KoNarRobotics/ModuCard-System/pcb/power-board/doc/mini_module_template-schematic.pdf

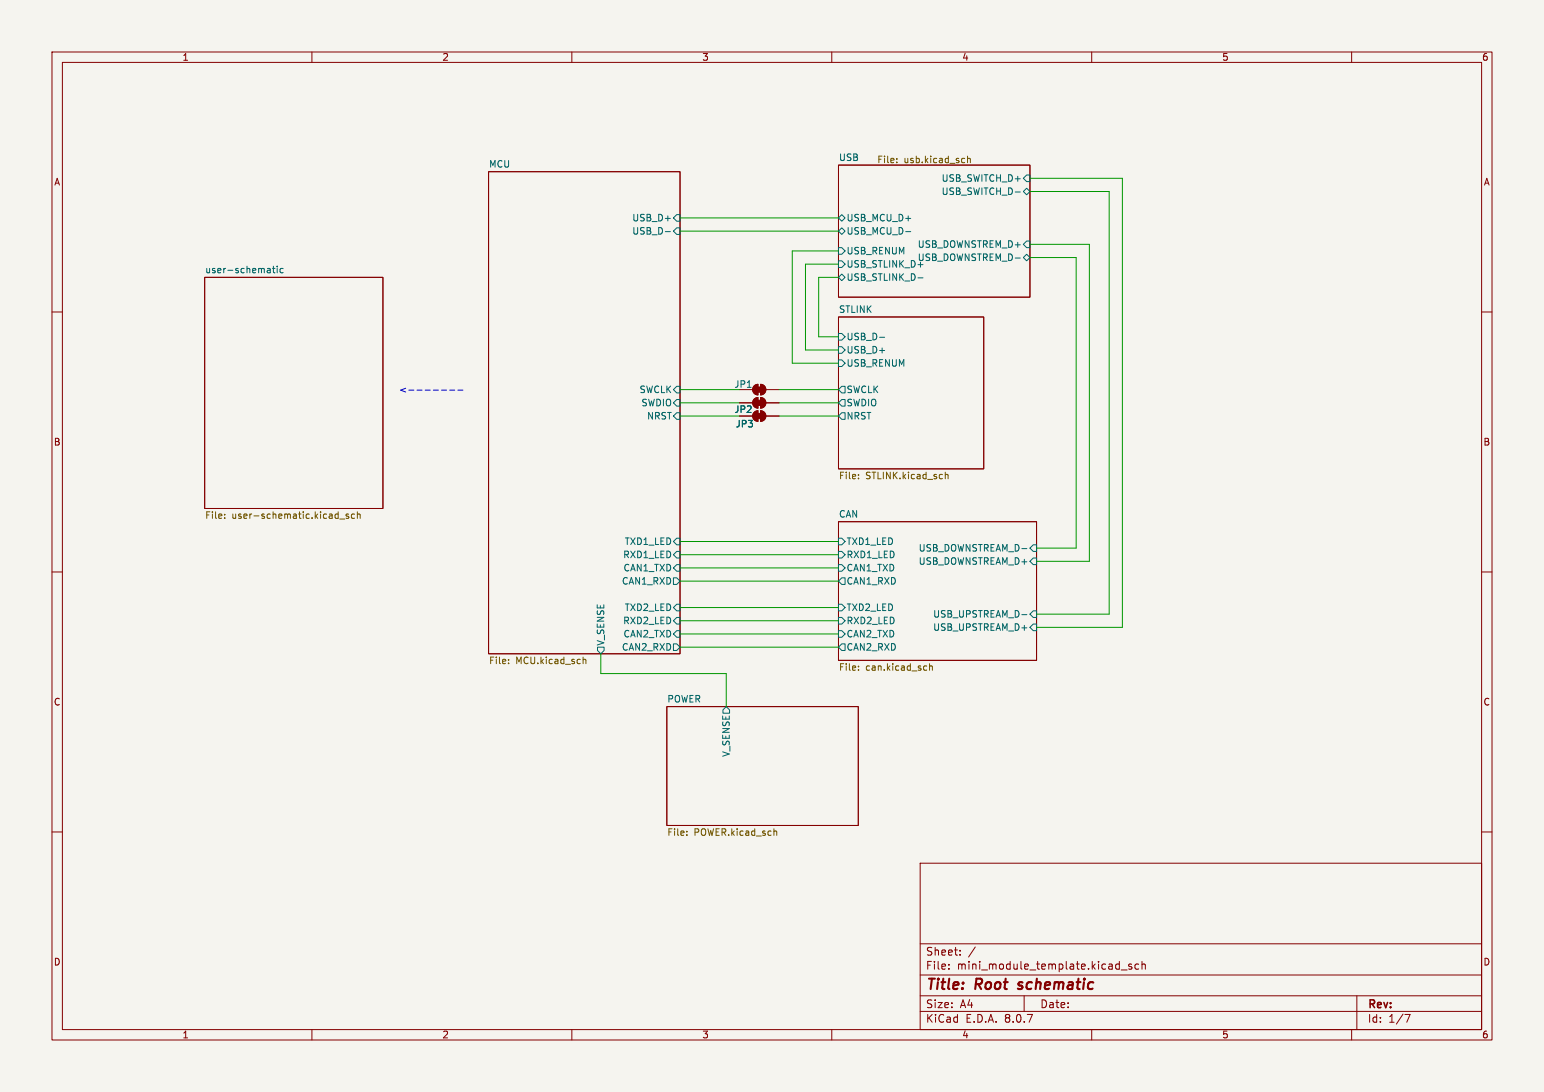
[picture p1: page 1]

File: mini_module_template.kicad_sch Sheet: /
Id: 1/7 Title: Root schematic

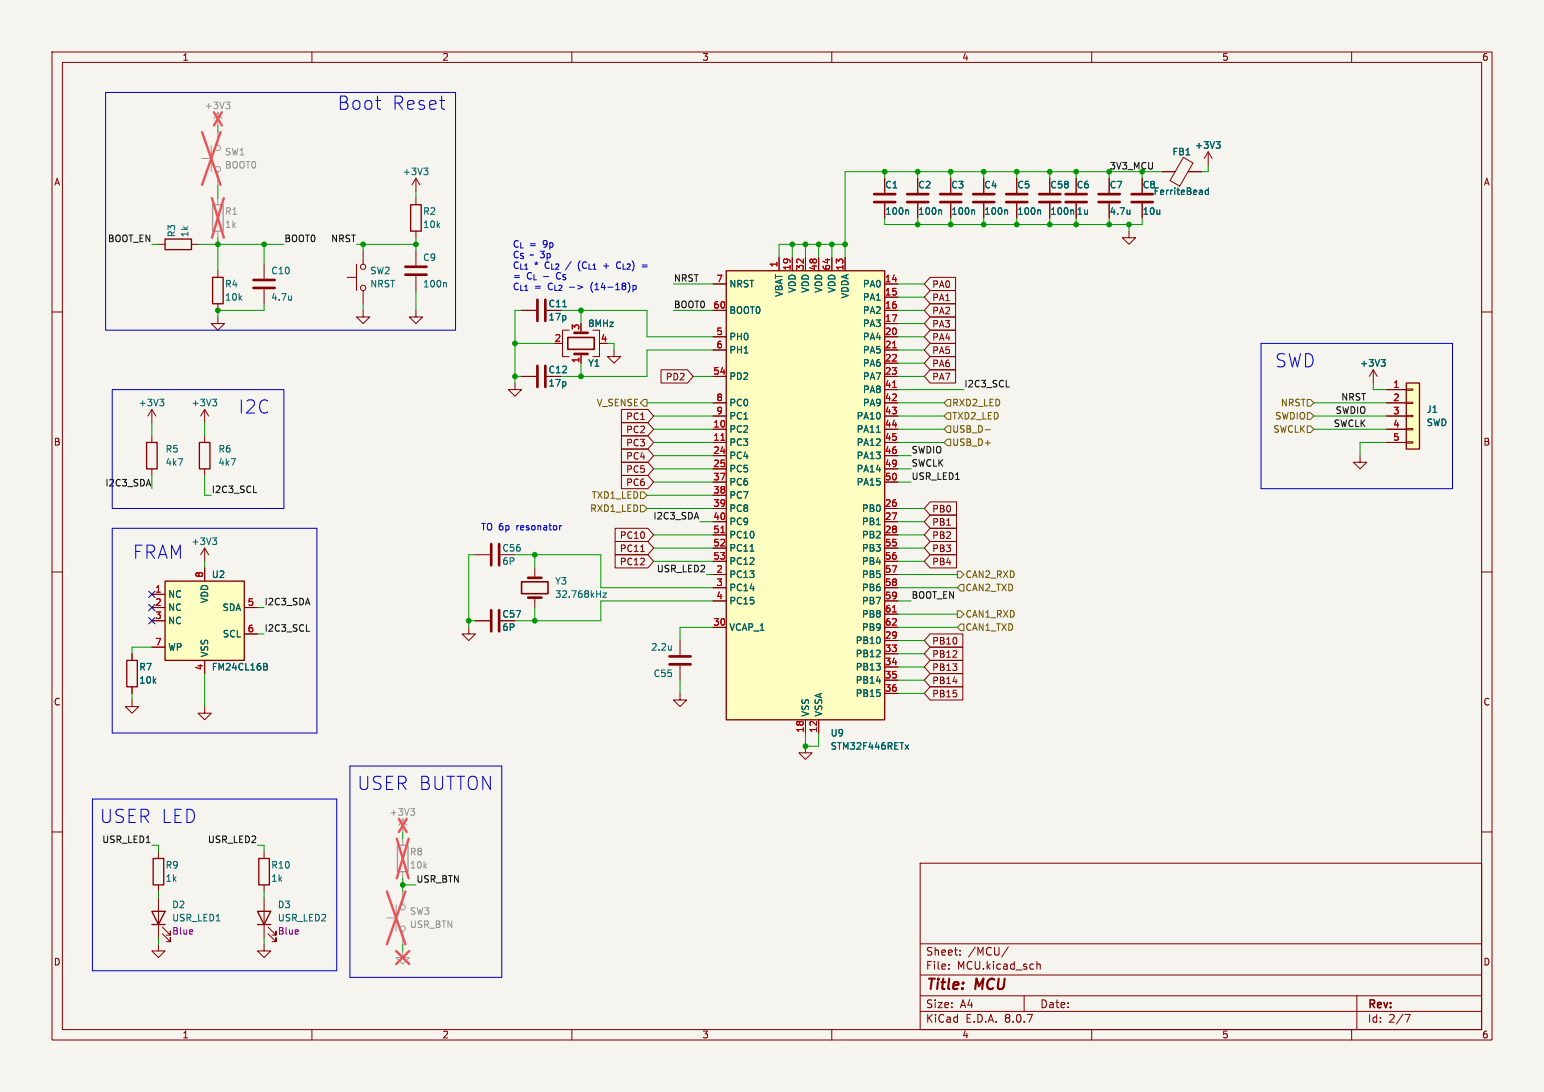
[picture p2: page 2]

1 PC2 10 PC3 11 VSSA 12 VDDA 13 PA0 14 PA1 15 PA2 16 PA3 17 VSS 18 VDD 19 PC13 2 PA4 20 PA5 21 PA6 22 PA7 23 PC4 24 PC5 25 PB0 26 PB1 27 PB2 28 PB10 29 PC14 3 VCAP_1 30 VDD 32 PB12 33 PB13 34 PB14 35 PB15 36 PC6 37 PC7 38 PC8 39 PC15 4 PC9 40 PA8 41 PA9 42 PA10 43 PA11 44 PA12 45 PA13 46 VDD 48 PA14 49 PH0 5 PA15 50 PC10 51 PC11 52 PC12 53 PD2 54 PB3 55 PB4 56 PB5 57 PB6 58 PB7 59 PH1 6 BOOT0 60 PB8 61 PB9 62 VDD 64 NRST 7 PC0 8 PC1 9 U9STM32F446RETx C11

1 PC2 10 PC3 11 VSSA 12 VDDA 13 PA0 14 PA1 15 PA2 16 PA3 17 VSS 18 VDD 19 PC13 2 PA4 20 PA5 21 PA6 22 PA7 23 PC4 24 PC5 25 PB0 26 PB1 27 PB2 28 PB10 29 PC14 3 VCAP_1 30 VDD 32 PB12 33 PB13 34 PB14 35 PB15 36 PC6 37 PC7 38 PC8 39 PC15 4 PC9 40 PA8 41 PA9 42 PA10 43 PA11 44 PA12 45 PA13 46 VDD 48 PA14 49 PH0 5 PA15 50 PC10 51 PC11 52 PC12 53 PD2 54 PB3 55 PB4 56 PB5 57 PB6 58 PB7 59 PH1 6 BOOT0 60 PB8 61 PB9 62 VDD 64 NRST 7 PC0 8 PC1 9 J1SWD

4 SDA 5 SCL 6 WP 7 VDD

File: MCU.kicad_sch Sheet: /MCU/ D2 USR_LED1 Blue R9

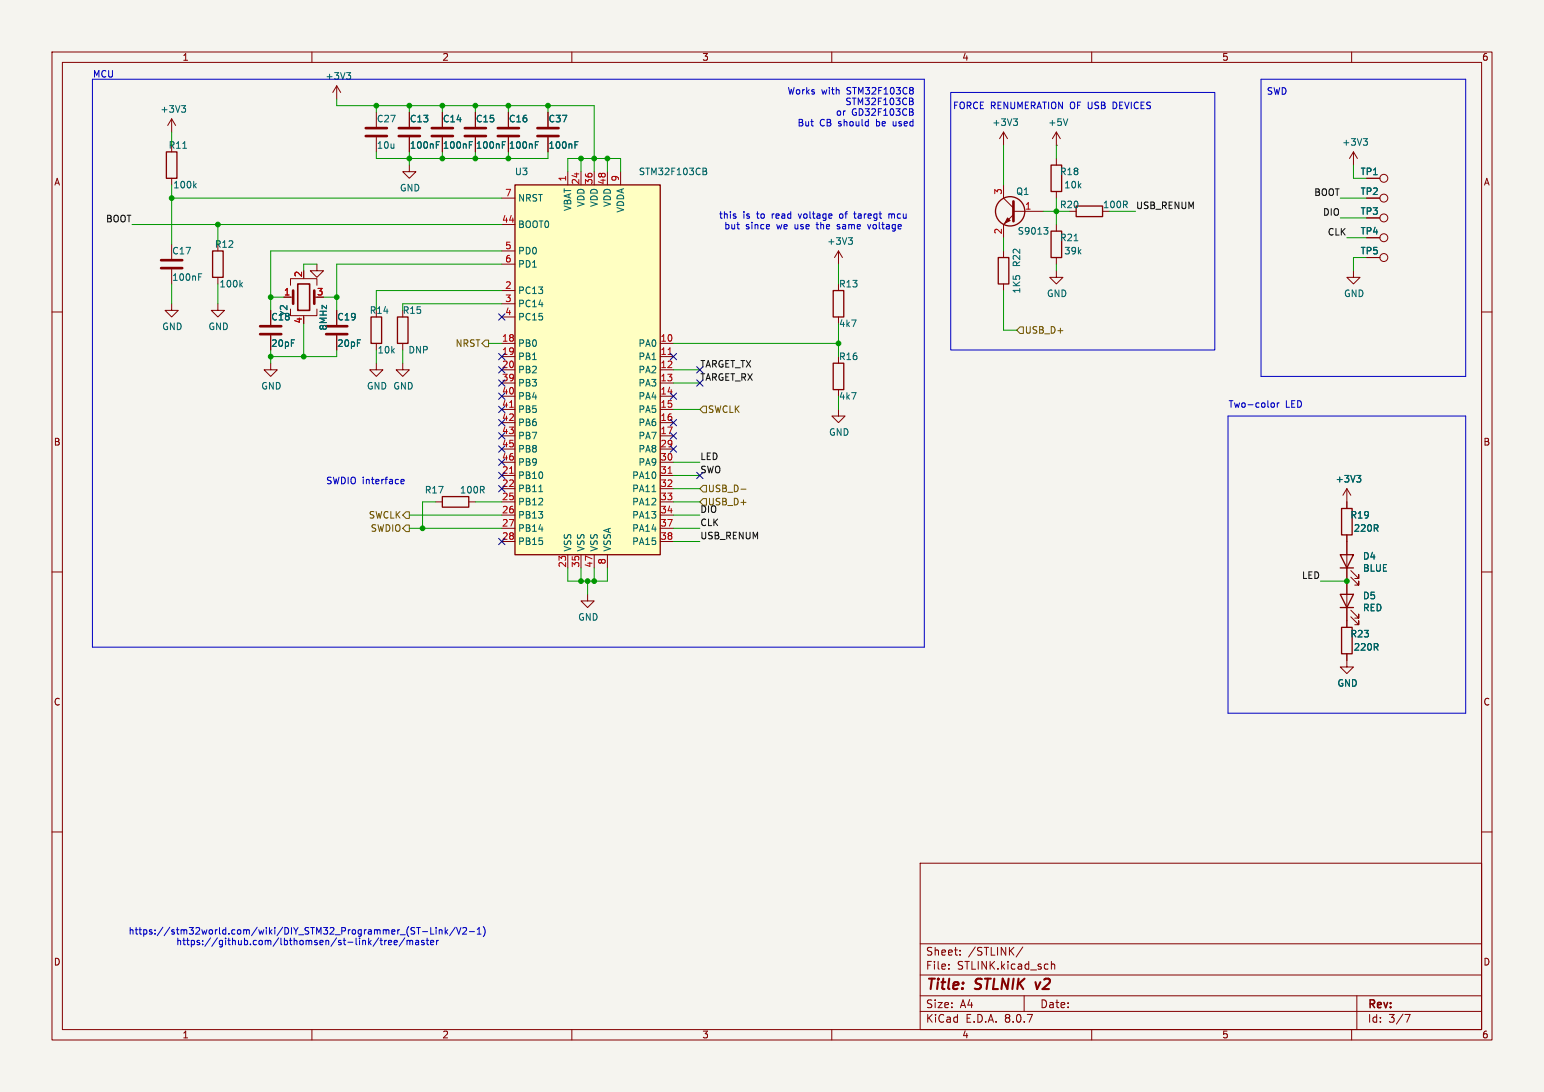
[picture p3: page 3]

But CB should be used MCU

but since we use the same voltage Works with STM32F103C8 STM32F103CB

FORCE RENUMERATION OF USB DEVICES

1 PA0 10 PA1 11 PA2 12 PA3 13 PA4 14 PA5 15 PA6 16 PA7 17 PB0 18 PB1 19 PC13 2 PB2 20 PB10 21 PB11 22 VSS 23 VDD 24 PB12 25 PB13 26 PB14 27 PB15 28 PA8 29 PC14 3 PA9 30 PA10 31 PA11 32 PA12 33 PA13 34 VSS 35 VDD 36 PA14 37 PA15 38 PB3 39 PC15 4 PB4 40 PB5 41 PB6 42 PB7 43 BOOT0 44 PB8 45 PB9 46 VSS 47 VDD 48 PD0 5 PD1 6 NRST 7 VSSA

CLK DIO this is to read voltage of taregt mcu

https://stm32world.com/wiki/DIY_STM32_Programmer_(ST-Link/V2-1)

https://github.com/lbthomsen/st-link/tree/master

File: STLINK.kicad_sch Sheet: /STLINK/
Id: 3/7 Title: STLNIK v2

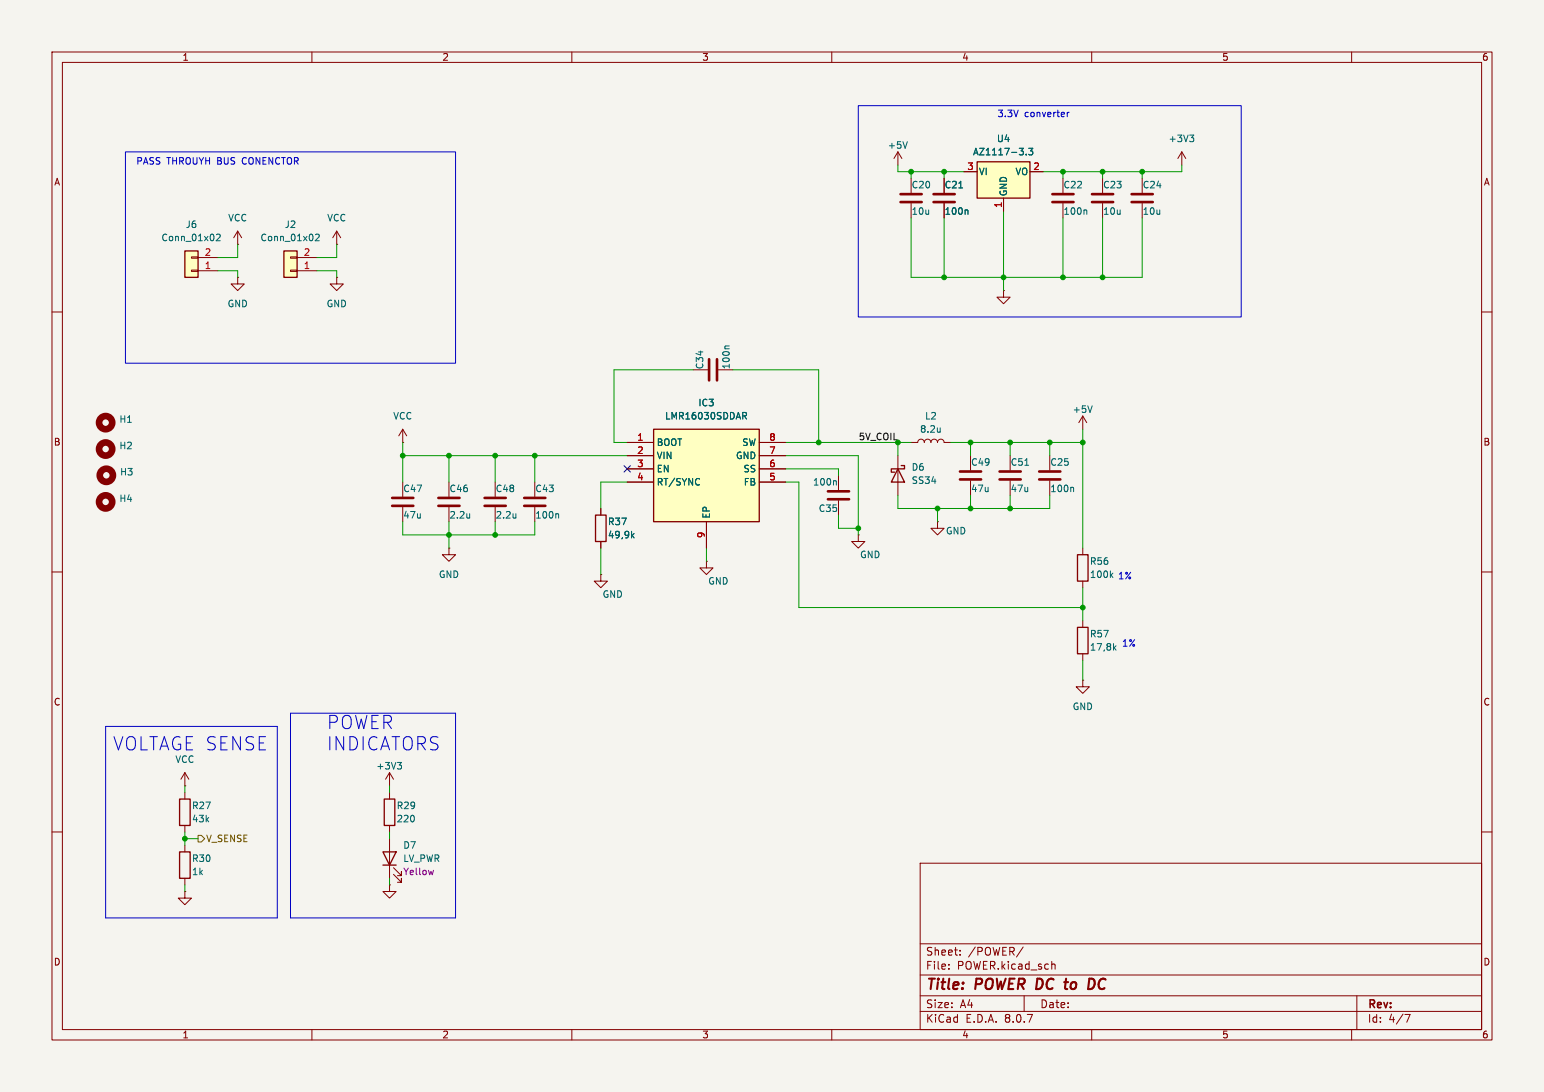
[picture p4: page 4]

PASS THROUYH BUS CONENCTOR

File: POWER.kicad_sch Sheet: /POWER/
Id: 4/7 Title: POWER DC to DC

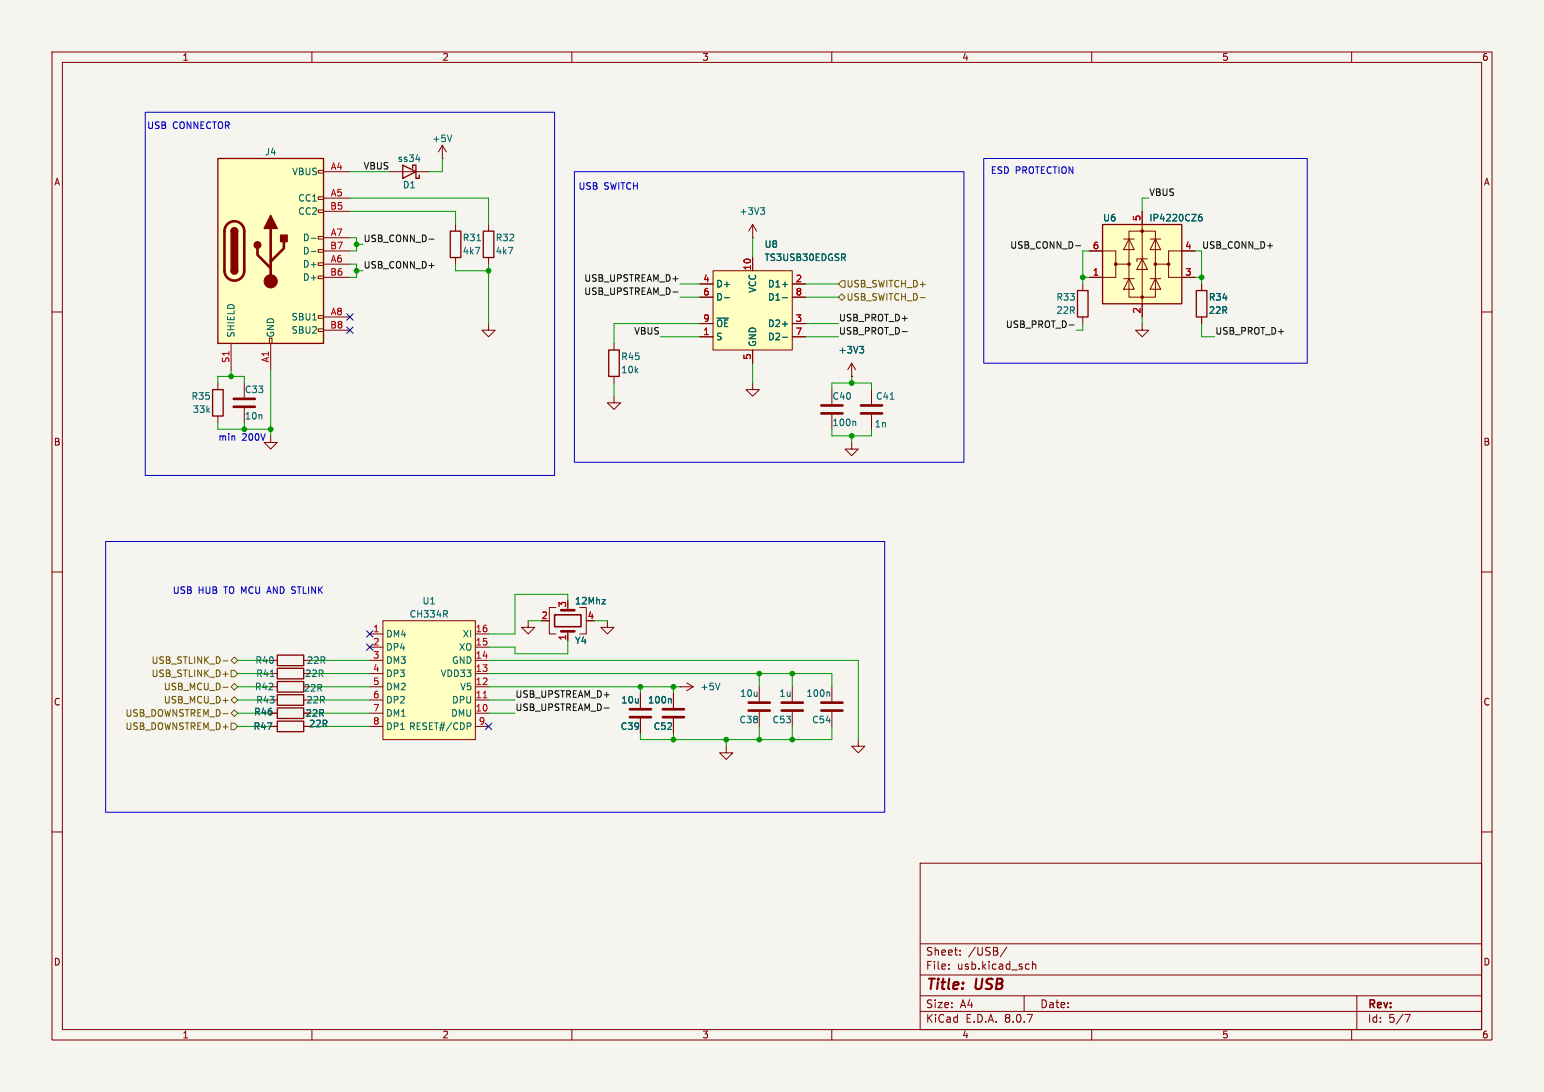
[picture p5: page 5]

USB CONNECTORmin 200V USB HUB TO MCU AND STLINK

File: usb.kicad_sch Sheet: /USB/
Id: 5/7 Title: USB

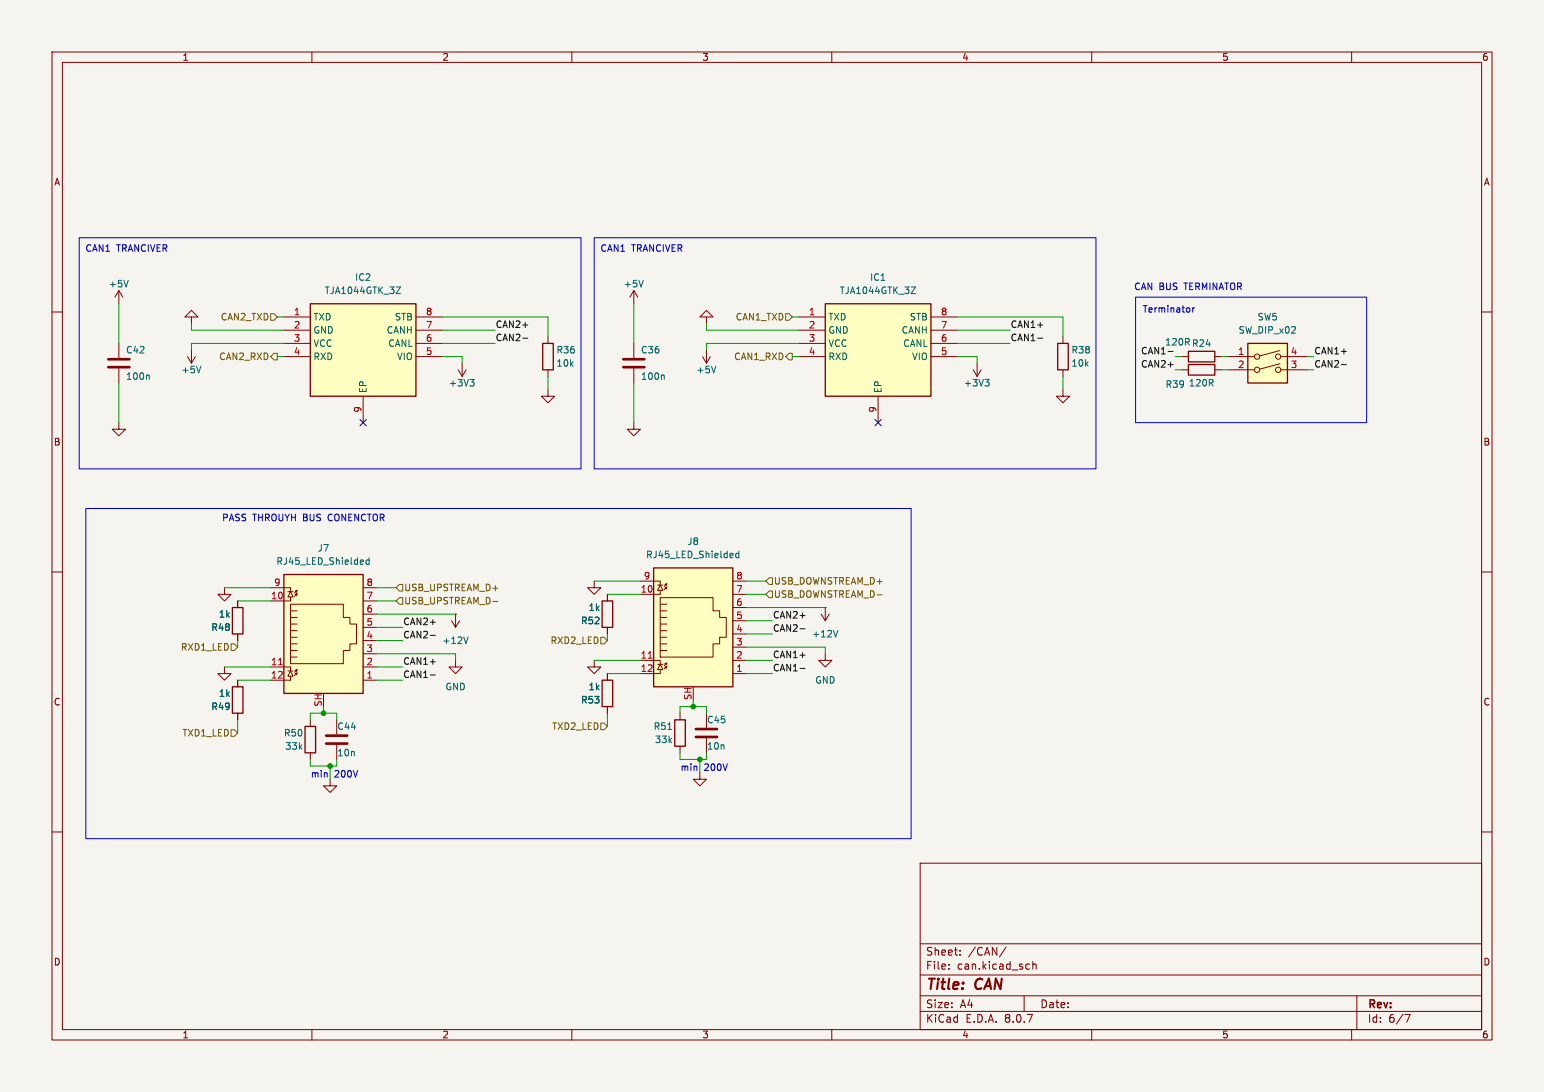
[picture p6: page 6]

PASS THROUYH BUS CONENCTOR

File: can.kicad_sch Sheet: /CAN/
Id: 6/7 Title: CAN

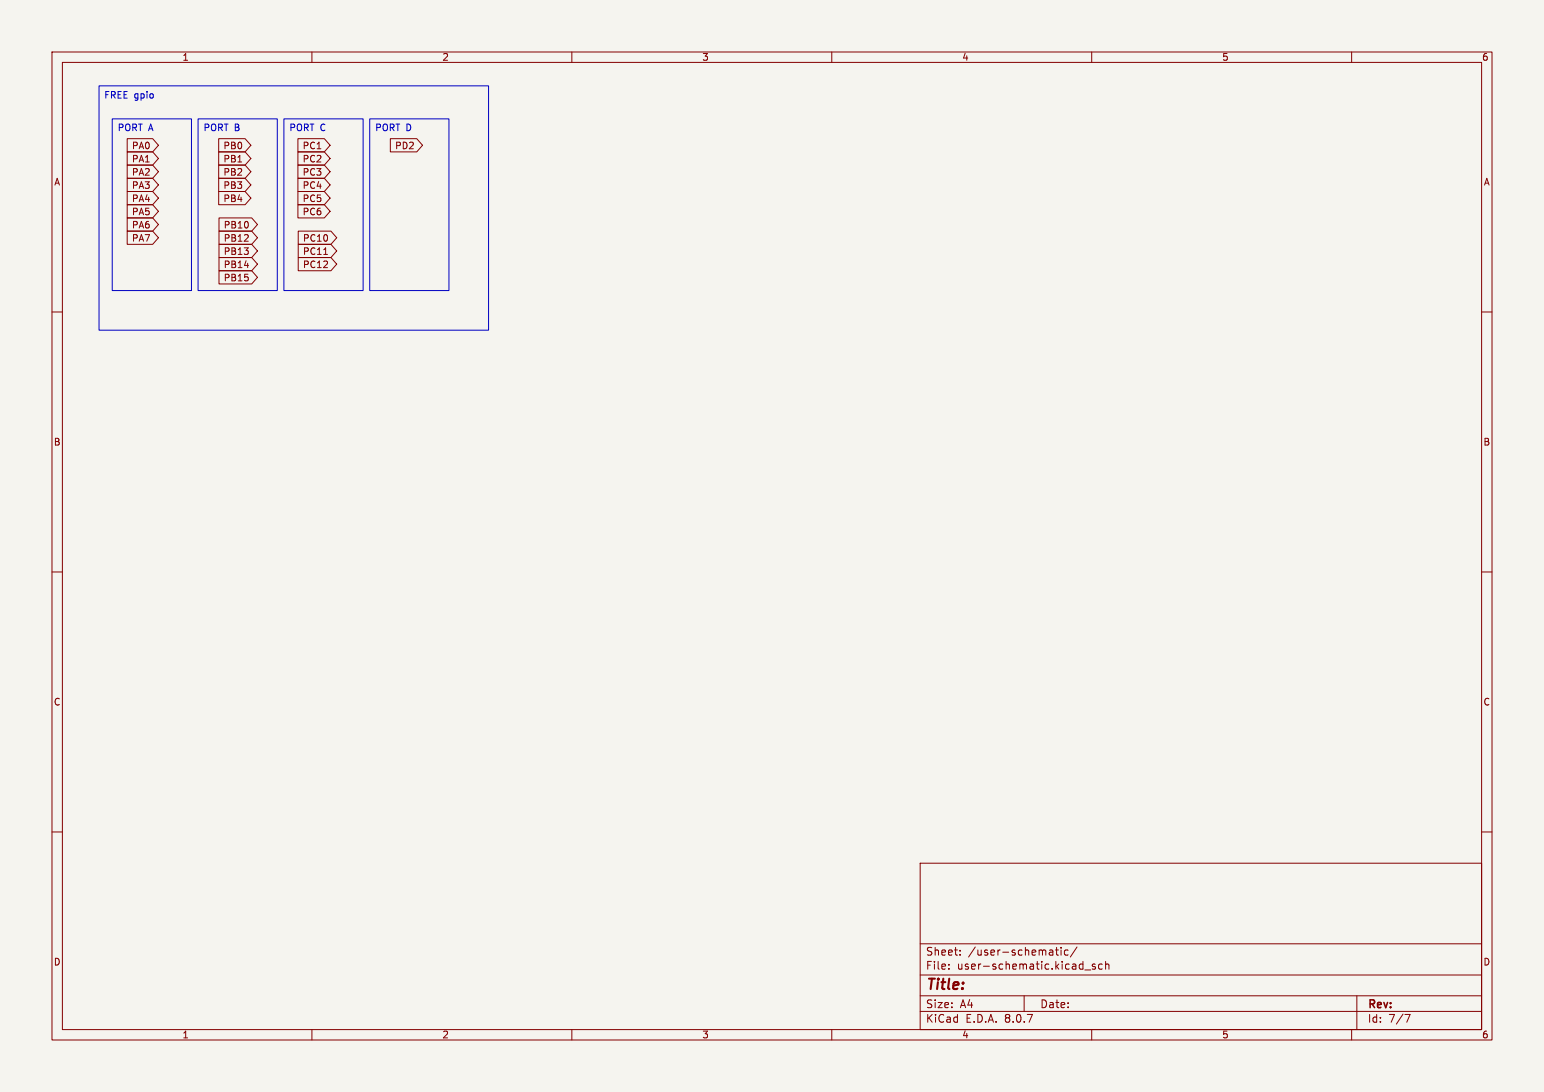
[picture p7: page 7]

Id: 7/7 Title: File: user-schematic.kicad_sch Sheet: /user-schematic/
