KoNarRobotics/ModuCard-System/pcb/power-board/mini_module_template.kicad_pcb

## KiCad design pcb/power-board/mini_module_template.kicad_pcb (2024-12-29)

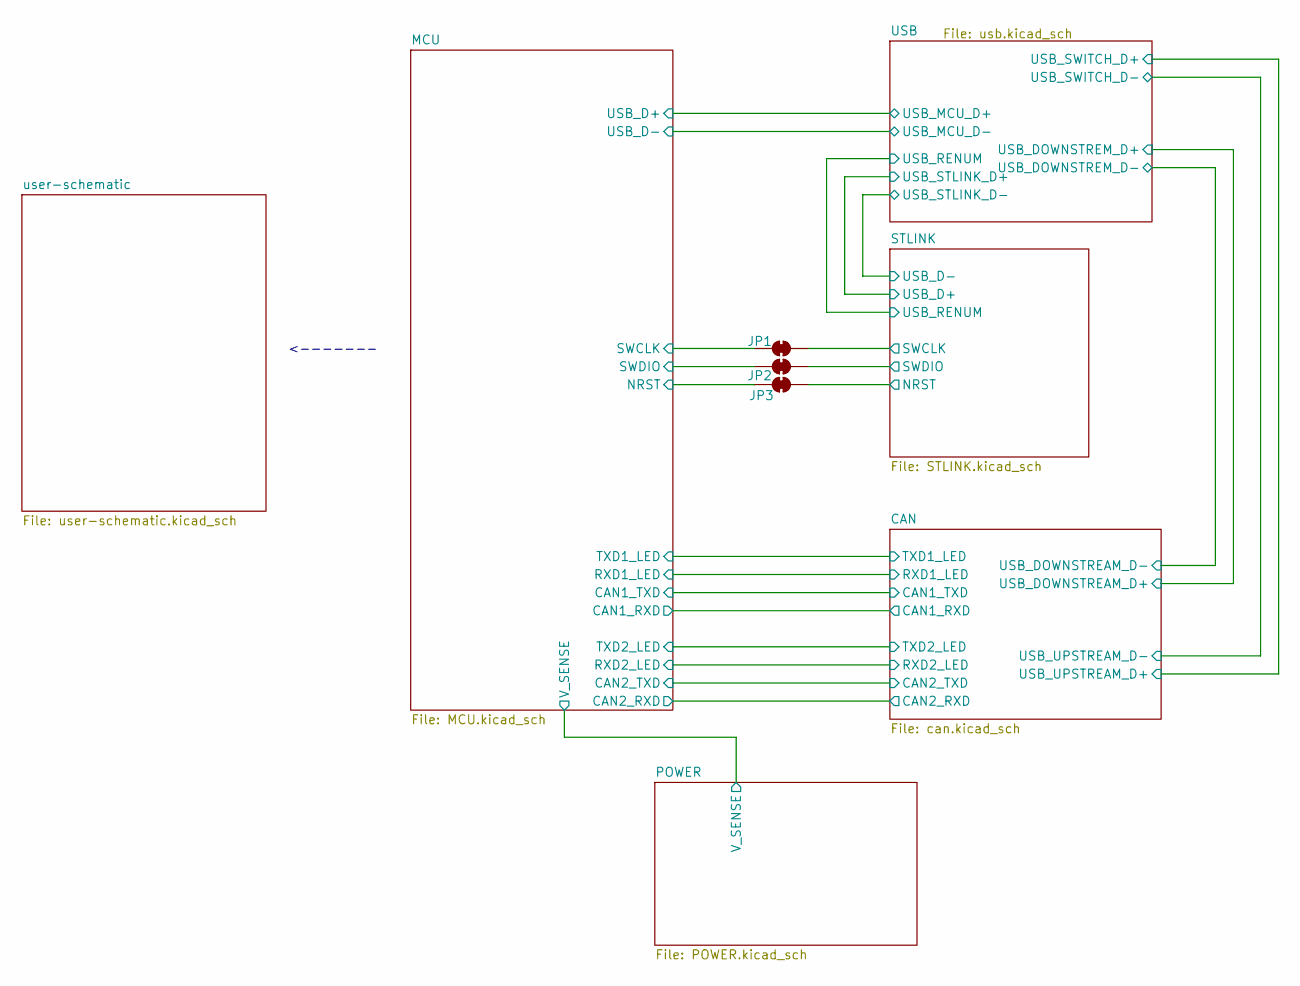
[picture p8: schematic mini_module_template.kicad_sch, Root schematic]

Parts:
JP1, JP2, JP3: SolderJumper_2_Bridged; SolderJumper-2_P1.3mm_Open_RoundedPad1.0x1.5mm

Connections:
/MCU/NRST: JP3.1 (A); also elsewhere on the board
/MCU/SWCLK: JP1.1 (A); also elsewhere on the board
/MCU/SWDIO: JP2.1 (A); also elsewhere on the board
/STLINK/NRST: JP3.2 (B); also elsewhere on the board
/STLINK/SWCLK: JP1.2 (B); also elsewhere on the board
/STLINK/SWDIO: JP2.2 (B); also elsewhere on the board

Notes on the sheet:
<-------

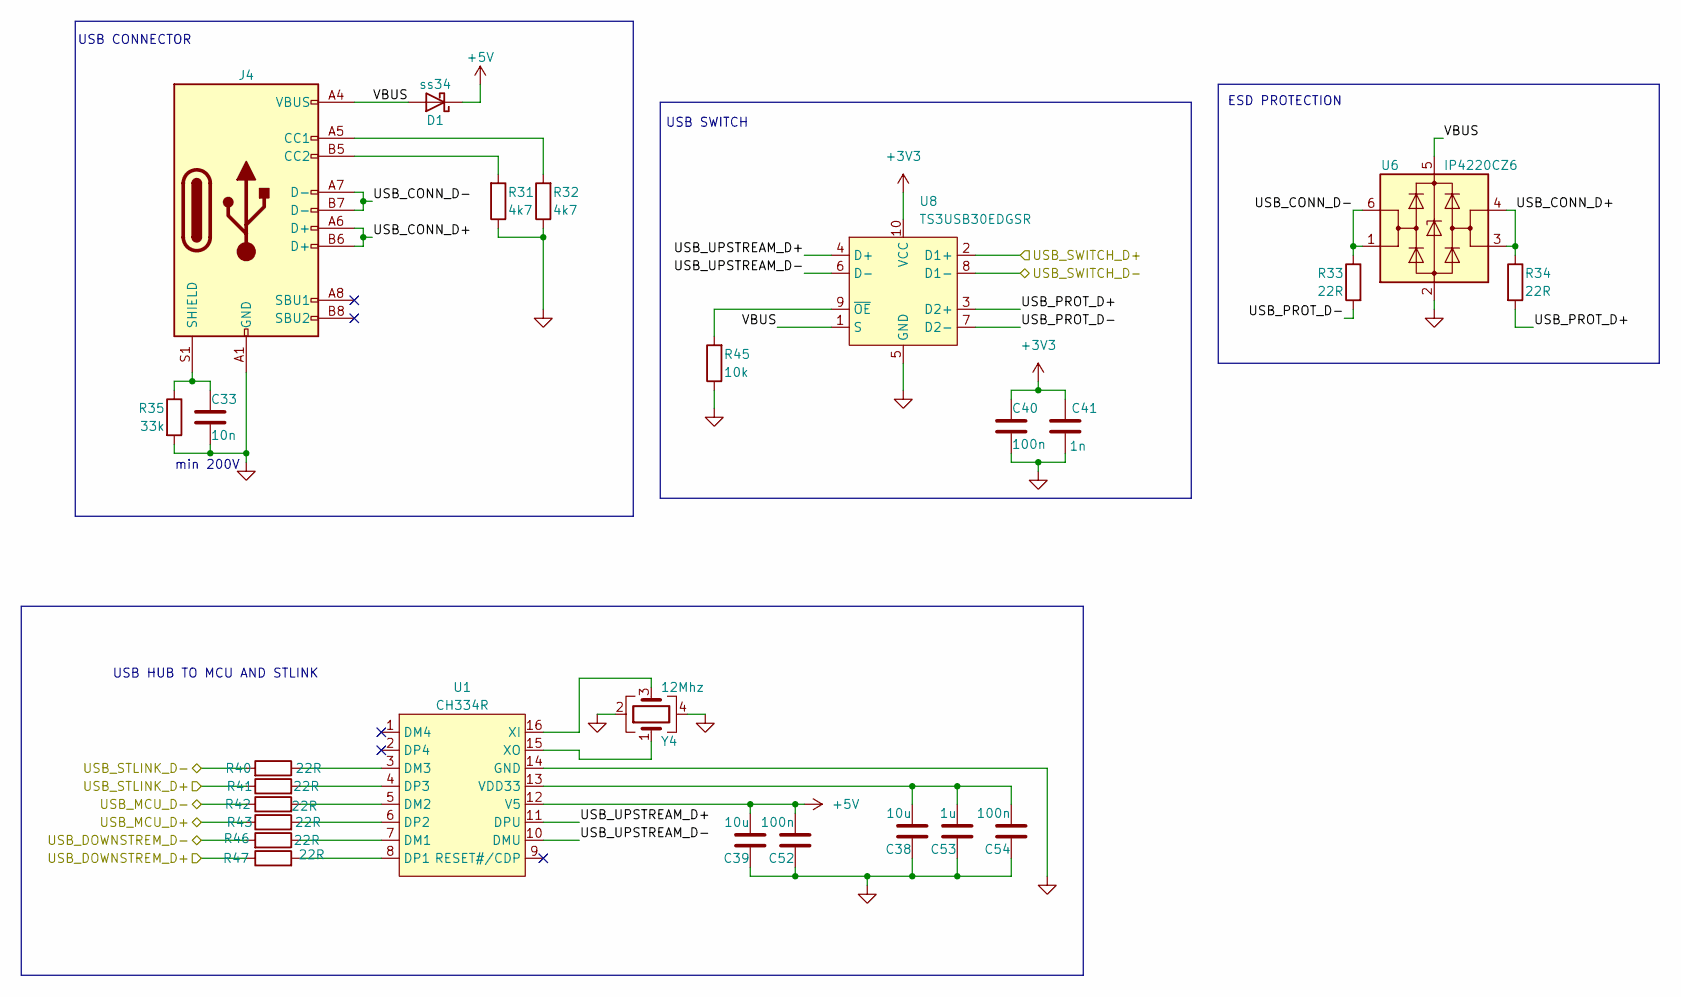
[picture p9: schematic usb.kicad_sch]

Parts:
C33: 10n; C_0402_1005Metric
C38, C39: 10u; C_0603_1608Metric
C40, C54: 100n; C_0402_1005Metric
C41: 1n; C_0402_1005Metric
C52: 100n; C_0603_1608Metric
C53: 1u; C_0603_1608Metric
D1: ss34; D_SMA
J4: USB_C_Receptacle_USB2.0; USB_C_Receptacle_G-Switch_GT-USB-7010ASV
R31, R32: 4k7; R_0402_1005Metric
R33, R34, R40, R41, R42, R43, R46, R47: 22R; R_0402_1005Metric
R35: 33k; R_0402_1005Metric
R45: 10k; R_0402_1005Metric
U1: CH334R; QSOP-16_3.9x4.9mm_P0.635mm
U6: IP4220CZ6; SOT-23-6
U8: TS3USB30EDGSR; VSSOP-10_3x3mm_P0.5mm
Y4: 12Mhz; Crystal_SMD_3225-4Pin_3.2x2.5mm

Connections:
+3V3: C40.1, C41.1, U8.10 (VCC); also elsewhere on the board
+5V: C39.2, C52.2, D1.1 (K), U1.12 (V5); also elsewhere on the board
/CAN/USB_DOWNSTREAM_D+: R47.1; also elsewhere on the board
/CAN/USB_DOWNSTREAM_D-: R46.2; also elsewhere on the board
/CAN/USB_UPSTREAM_D+: U8.2 (D1+); also elsewhere on the board
/CAN/USB_UPSTREAM_D-: U8.8 (D1-); also elsewhere on the board
/MCU/USB_D+: R43.1; also elsewhere on the board
/MCU/USB_D-: R42.1; also elsewhere on the board
/STLINK/USB_D+: R41.1; also elsewhere on the board
/STLINK/USB_D-: R40.2; also elsewhere on the board
/USB/USB_CONN_D+: J4.A6 (D+), J4.B6 (D+), R34.1, U6.3 (I/O2), U6.4 (I/O2)
/USB/USB_CONN_D-: J4.A7 (D-), J4.B7 (D-), R33.1, U6.1 (I/O1), U6.6 (I/O1)
/USB/USB_PROT_D+: R34.2, U8.3 (D2+)
/USB/USB_PROT_D-: R33.2, U8.7 (D2-)
/USB/USB_UPSTREAM_D+: U1.11 (DPU), U8.4 (D+)
/USB/USB_UPSTREAM_D-: U1.10 (DMU), U8.6 (D-)
/USB/VBUS: D1.2 (A), J4.A4 (VBUS), J4.A9 (VBUS), J4.B4 (VBUS), J4.B9 (VBUS), U6.5 (VBUS), U8.1 (S)
GND: C33.2, C38.1, C39.1, C40.2, C41.2, C52.1, C53.1, C54.1, J4.A1 (GND), J4.A12 (GND), J4.B1 (GND), J4.B12 (GND), R31.1, R32.1, R35.2, R45.1, U1.14 (GND), U6.2 (GND), U8.5 (GND), Y4.2, Y4.4; also elsewhere on the board
unnamed: J4.A5 (CC1), R32.2
unnamed: J4.B5 (CC2), R31.2
unnamed: C33.1, J4.S1 (SHIELD), R35.1
unnamed: R46.1, U1.7 (DM1)
unnamed: R42.2, U1.5 (DM2)
unnamed: R40.1, U1.3 (DM3)
unnamed: R47.2, U1.8 (DP1)
unnamed: R43.2, U1.6 (DP2)
unnamed: R41.2, U1.4 (DP3)
unnamed: C38.2, C53.2, C54.2, U1.13 (VDD33)
unnamed: U1.16 (XI), Y4.3
unnamed: U1.15 (XO), Y4.1
unnamed: R45.2, U8.9 (~OE)

Notes on the sheet:
USB SWITCH
USB CONNECTOR
USB HUB TO MCU AND STLINK
ESD PROTECTION
min 200V

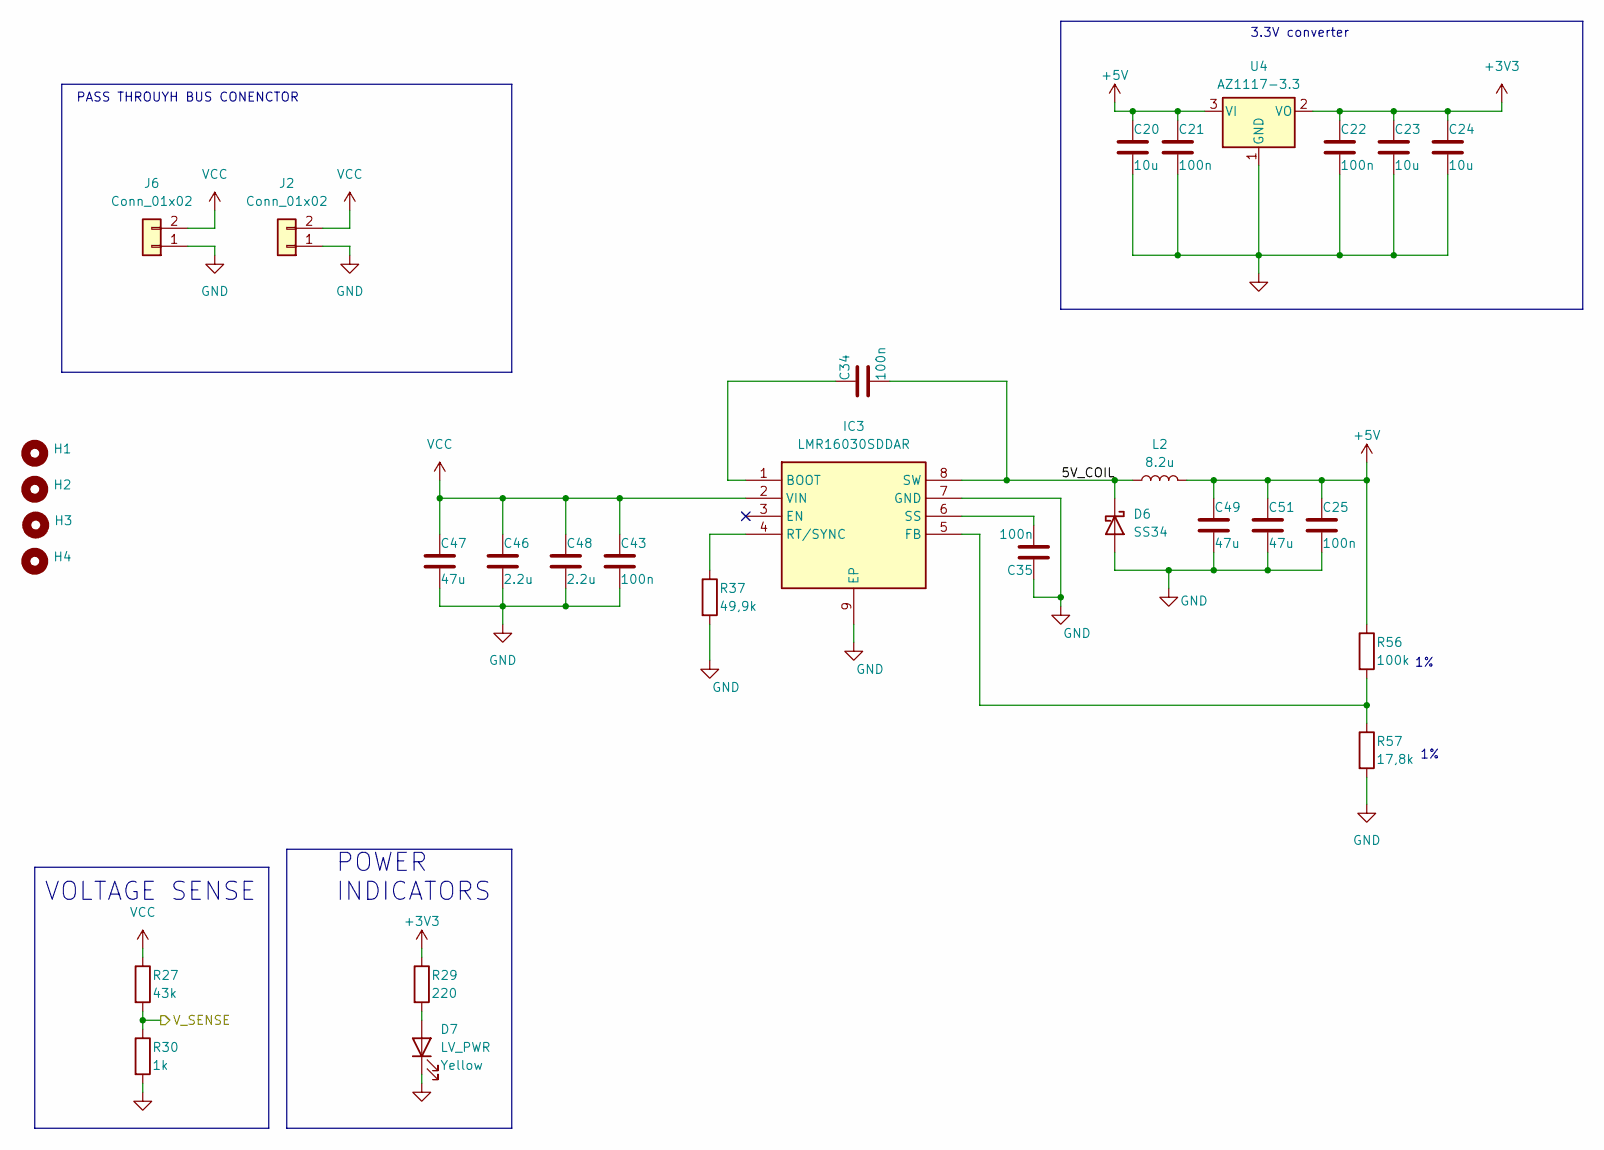
[picture p10: schematic POWER.kicad_sch, POWER DC to DC]

Parts:
C20, C23, C24: 10u; C_0805_2012Metric
C21, C25, C34, C35, C43: 100n; C_0402_1005Metric
C22: 100n; C_0603_1608Metric
C46, C48: 2.2u; C_1206_3216Metric
C47: 47u; C_Elec_10x10.2
C49, C51: 47u; C_1206_3216Metric
D6: SS34; D_SMA
D7: LV_PWR; D_0603_1608Metric
H1, H2, H3, H4: MountingHole_3.2mm_M3
IC3: LMR16030SDDAR; SOIC127P600X170-9N; Manufacturer_Part_Number LMR16030SDDAR; Mouser Part Number 595-LMR16030SDDAR
J2, J6: Conn_01x02; AMASS_XT60PW-M_1x02_P7.20mm_Horizontal
L2: 8.2u; L_Cenker_CKCS6045
R27: 43k; R_0402_1005Metric
R29: 220; R_0402_1005Metric
R30: 1k; R_0402_1005Metric
R37: 49,9k; R_0402_1005Metric
R56: 100k; R_0402_1005Metric
R57: 17,8k; R_0402_1005Metric
U4: AZ1117-3.3; SOT-223-3_TabPin2

Connections:
+3V3: C22.1, C23.1, C24.1, R29.1, U4.2 (VO); also elsewhere on the board
+5V: C20.1, C21.1, C25.1, C49.1, C51.1, L2.2, R56.1, U4.3 (VI); also elsewhere on the board
/MCU/V_SENSE: R27.2, R30.1; also elsewhere on the board
/POWER/5V_COIL: C34.2, D6.1 (K), IC3.8 (SW), L2.1
GND: C20.2, C21.2, C22.2, C23.2, C24.2, C25.2, C35.1, C43.2, C46.2, C47.2, C48.2, C49.2, C51.2, D6.2 (A), D7.1 (K), IC3.7 (GND), IC3.9 (EP), J2.1, J6.1, R30.2, R37.2, R57.2, U4.1 (GND); also elsewhere on the board
unnamed: D7.2 (A), R29.2
unnamed: C34.1, IC3.1 (BOOT)
unnamed: IC3.5 (FB), R56.2, R57.1
unnamed: IC3.4 (RT/SYNC), R37.1
unnamed: C35.2, IC3.6 (SS)
VCC: C43.1, C46.1, C47.1, C48.1, IC3.2 (VIN), J2.2, J6.2, R27.1

Notes on the sheet:
VOLTAGE SENSE
PASS THROUYH BUS CONENCTOR
POWER INDICATORS
3.3V converter

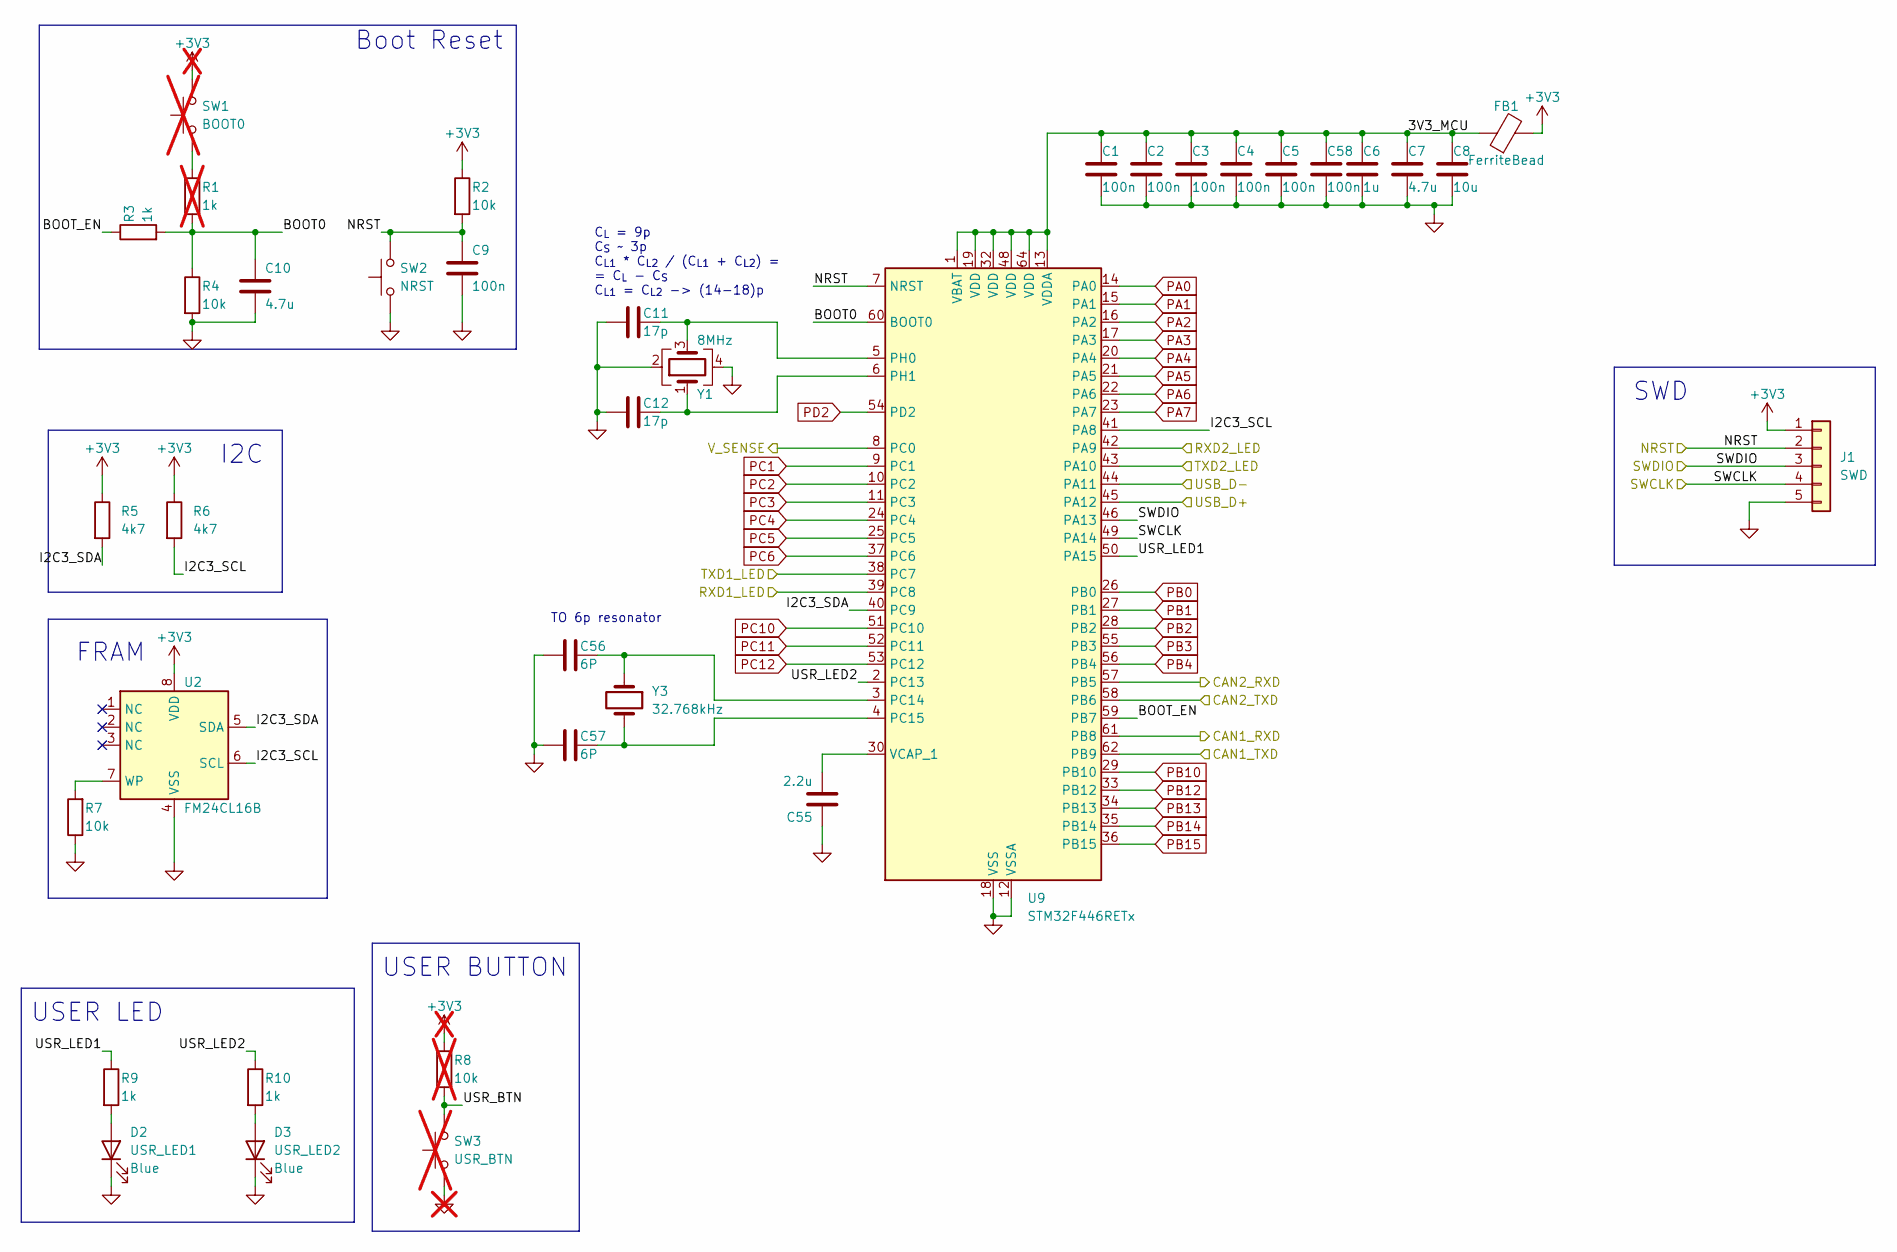
[picture p11: schematic MCU.kicad_sch]

Parts:
C1, C2, C3, C4, C5, C9, C58: 100n; C_0402_1005Metric
C6: 1u; C_0603_1608Metric
C7: 4.7u; C_0603_1608Metric
C8: 10u; C_0805_2012Metric
C10: 4.7u; C_0402_1005Metric
C11, C12: 17p; C_0402_1005Metric
C55: 2.2u; C_0402_1005Metric
C56, C57: 6P; C_0402_1005Metric
D2: USR_LED1; D_0603_1608Metric
D3: USR_LED2; D_0603_1608Metric
FB1: FerriteBead; L_0805_2012Metric
J1: SWD; PinSocket_1x05_P2.54mm_Vertical
R1: 1k; R_0402_1005Metric; not fitted
R2, R4, R7: 10k; R_0402_1005Metric
R3, R9, R10: 1k; R_0402_1005Metric
R5, R6: 4k7; R_0402_1005Metric
R8: 10k; R_0402_1005Metric; not fitted
SW1: BOOT0; SW_Tactile_SPST_Angled_PTS645Vx58-2LFS; not fitted
SW2: NRST; SW_Tactile_SPST_Angled_PTS645Vx58-2LFS
SW3: USR_BTN; SW_Tactile_SPST_Angled_PTS645Vx58-2LFS; not fitted
U2: FM24CL16B; SOIC-8_3.9x4.9mm_P1.27mm
U9: STM32F446RETx; LQFP-64_10x10mm_P0.5mm
Y1: 8MHz; Crystal_SMD_3225-4Pin_3.2x2.5mm
Y3: 32.768kHz; Crystal_SMD_3215-2Pin_3.2x1.5mm

Connections:
+3V3: FB1.2, J1.1, R2.1, R5.1, R6.1, R8.1, SW1.2, U2.8 (VDD); also elsewhere on the board
/CAN/CAN1_RXD: U9.61 (PB8); also elsewhere on the board
/CAN/CAN1_TXD: U9.62 (PB9); also elsewhere on the board
/CAN/CAN2_RXD: U9.57 (PB5); also elsewhere on the board
/CAN/CAN2_TXD: U9.58 (PB6); also elsewhere on the board
/CAN/RXD1_LED: U9.39 (PC8); also elsewhere on the board
/CAN/RXD2_LED: U9.42 (PA9); also elsewhere on the board
/CAN/TXD1_LED: U9.38 (PC7); also elsewhere on the board
/CAN/TXD2_LED: U9.43 (PA10); also elsewhere on the board
/MCU/3V3_MCU: C1.1, C2.1, C3.1, C4.1, C5.1, C6.1, C7.1, C8.1, C58.1, FB1.1, U9.1 (VBAT), U9.13 (VDDA), U9.19 (VDD), U9.32 (VDD), U9.48 (VDD), U9.64 (VDD)
/MCU/BOOT0: C10.1, R1.2, R3.2, R4.1, U9.60 (BOOT0)
/MCU/BOOT_EN: R3.1, U9.59 (PB7)
/MCU/I2C3_SCL: R6.2, U2.6 (SCL), U9.41 (PA8)
/MCU/I2C3_SDA: R5.2, U2.5 (SDA), U9.40 (PC9)
/MCU/NRST: C9.1, J1.2, R2.2, SW2.2, U9.7 (NRST); also elsewhere on the board
/MCU/SWCLK: J1.4, U9.49 (PA14); also elsewhere on the board
/MCU/SWDIO: J1.3, U9.46 (PA13); also elsewhere on the board
/MCU/USB_D+: U9.45 (PA12); also elsewhere on the board
/MCU/USB_D-: U9.44 (PA11); also elsewhere on the board
/MCU/USR_LED1: R9.1, U9.50 (PA15)
/MCU/USR_LED2: R10.1, U9.2 (PC13)
/MCU/V_SENSE: U9.8 (PC0); also elsewhere on the board
GND: C1.2, C2.2, C3.2, C4.2, C5.2, C6.2, C7.2, C8.2, C9.2, C10.2, C11.1, C12.1, C55.1, C56.1, C57.1, C58.2, D2.1 (K), D3.1 (K), J1.5, R4.2, R7.1, SW2.1, SW3.1, U2.4 (VSS), U9.12 (VSSA), U9.18 (VSS), U9.31 (VSS), U9.47 (VSS), U9.63 (VSS), Y1.2, Y1.4; also elsewhere on the board
unnamed: D2.2 (A), R9.2
unnamed: D3.2 (A), R10.2
unnamed: R1.1, SW1.1
unnamed: R8.2, SW3.2
unnamed: R7.2, U2.7 (WP)
unnamed: C56.2, U9.3 (PC14), Y3.1
unnamed: C57.2, U9.4 (PC15), Y3.2
unnamed: C11.2, U9.5 (PH0), Y1.3
unnamed: C12.2, U9.6 (PH1), Y1.1
unnamed: C55.2, U9.30 (VCAP_1)
PA0: U9.14 (PA0)
PA1: U9.15 (PA1)
PA2: U9.16 (PA2)
PA3: U9.17 (PA3)
PA4: U9.20 (PA4)
PA5: U9.21 (PA5)
PA6: U9.22 (PA6)
PA7: U9.23 (PA7)
PB0: U9.26 (PB0)
PB1: U9.27 (PB1)
PB2: U9.28 (PB2)
PB3: U9.55 (PB3)
PB4: U9.56 (PB4)
PB10: U9.29 (PB10)
PB12: U9.33 (PB12)
PB13: U9.34 (PB13)
PB14: U9.35 (PB14)
PB15: U9.36 (PB15)
PC1: U9.9 (PC1)
PC2: U9.10 (PC2)
PC3: U9.11 (PC3)
PC4: U9.24 (PC4)
PC5: U9.25 (PC5)
PC6: U9.37 (PC6)
PC10: U9.51 (PC10)
PC11: U9.52 (PC11)
PC12: U9.53 (PC12)
PD2: U9.54 (PD2)

Notes on the sheet:
SWD
I2C
USER BUTTON
TO 6p resonator
FRAM
C_{L} = 9p C_{S} ~ 3p C_{L1} * C_{L2} / (C_{L1} + C_{L2}) = = C_{L} - C_{S} C_{L1} = C_{L2} -> (14-18)p
USER LED
Boot Reset

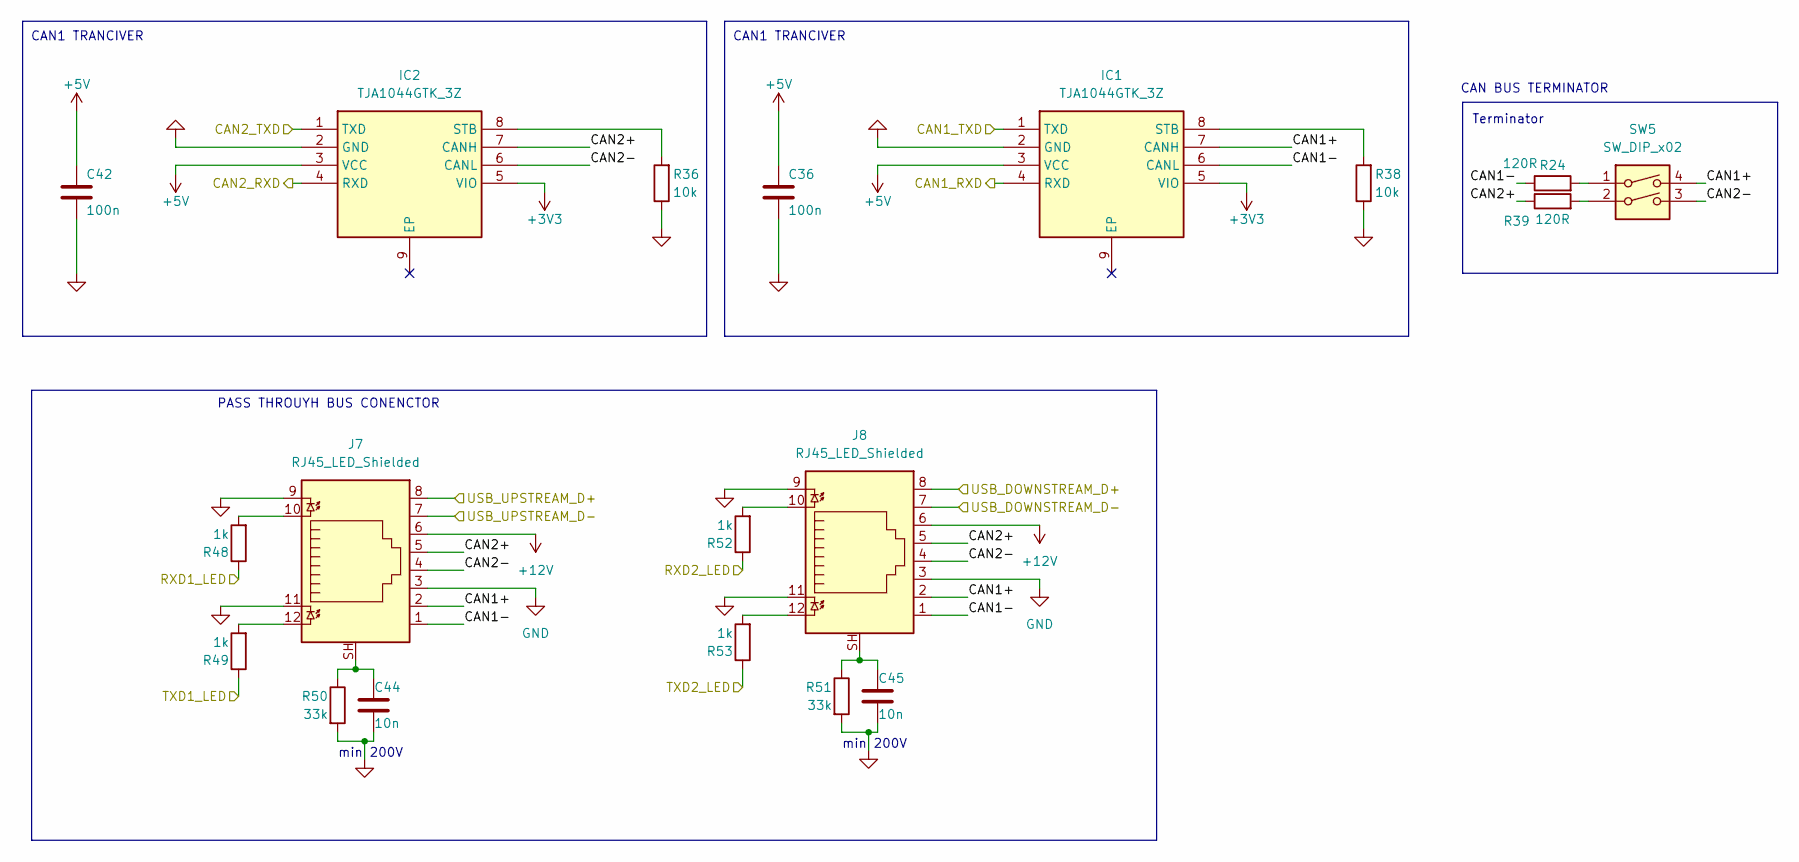
[picture p12: schematic can.kicad_sch]

Parts:
C36, C42: 100n; C_0402_1005Metric
C44, C45: 10n; C_0402_1005Metric
IC1, IC2: TJA1044GTK_3Z; SON65P300X300X100-9N-D; Manufacturer_Part_Number TJA1044GTK/3Z; Mouser Part Number 771-TJA1044GTK/3Z
J7, J8: RJ45_LED_Shielded; RJ45_Amphenol_RJHSE538X
R24, R39: 120R; R_0603_1608Metric
R36, R38: 10k; R_0402_1005Metric
R48, R49, R52, R53: 1k; R_0402_1005Metric
R50, R51: 33k; R_0402_1005Metric
SW5: SW_DIP_x02; SW_DIP_SPSTx02_Slide_6.7x6.64mm_W7.62mm_P2.54mm_LowProfile

Connections:
+3V3: IC1.5 (VIO), IC2.5 (VIO); also elsewhere on the board
+5V: C36.1, C42.1, IC1.3 (VCC), IC2.3 (VCC); also elsewhere on the board
+12V: J7.6, J8.6
/CAN/CAN1+: IC1.7 (CANH), J7.2, J8.2, SW5.4
/CAN/CAN1-: IC1.6 (CANL), J7.1, J8.1, R24.1
/CAN/CAN1_RXD: IC1.4 (RXD); also elsewhere on the board
/CAN/CAN1_TXD: IC1.1 (TXD); also elsewhere on the board
/CAN/CAN2+: IC2.7 (CANH), J7.5, J8.5, R39.1
/CAN/CAN2-: IC2.6 (CANL), J7.4, J8.4, SW5.3
/CAN/CAN2_RXD: IC2.4 (RXD); also elsewhere on the board
/CAN/CAN2_TXD: IC2.1 (TXD); also elsewhere on the board
/CAN/RXD1_LED: R48.1; also elsewhere on the board
/CAN/RXD2_LED: R52.1; also elsewhere on the board
/CAN/TXD1_LED: R49.1; also elsewhere on the board
/CAN/TXD2_LED: R53.1; also elsewhere on the board
/CAN/USB_DOWNSTREAM_D+: J8.8; also elsewhere on the board
/CAN/USB_DOWNSTREAM_D-: J8.7; also elsewhere on the board
/CAN/USB_UPSTREAM_D+: J7.8; also elsewhere on the board
/CAN/USB_UPSTREAM_D-: J7.7; also elsewhere on the board
GND: C36.2, C42.2, C44.2, C45.2, IC1.2 (GND), IC2.2 (GND), J7.3, J7.9, J7.11, J8.3, J8.9, J8.11, R36.1, R38.1, R50.2, R51.2; also elsewhere on the board
unnamed: C44.1, J7.SH, R50.1
unnamed: C45.1, J8.SH, R51.1
unnamed: IC1.8 (STB), R38.2
unnamed: IC2.8 (STB), R36.2
unnamed: J7.10, R48.2
unnamed: J7.12, R49.2
unnamed: J8.10, R52.2
unnamed: J8.12, R53.2
unnamed: R24.2, SW5.1
unnamed: R39.2, SW5.2

Notes on the sheet:
min 200V
CAN1 TRANCIVER
PASS THROUYH BUS CONENCTOR
Terminator
CAN BUS TERMINATOR

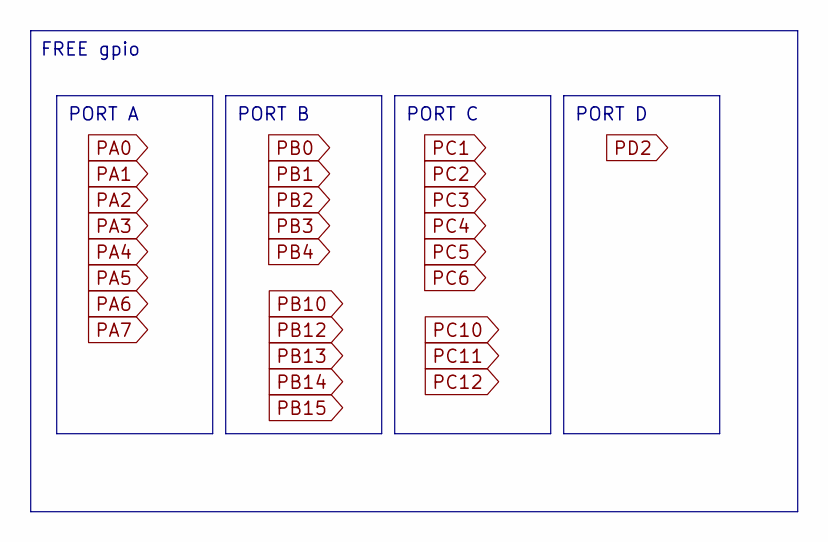
[picture p13: schematic user-schematic.kicad_sch]

Notes on the sheet:
PORT D
PORT B
PORT C
PORT A
FREE gpio

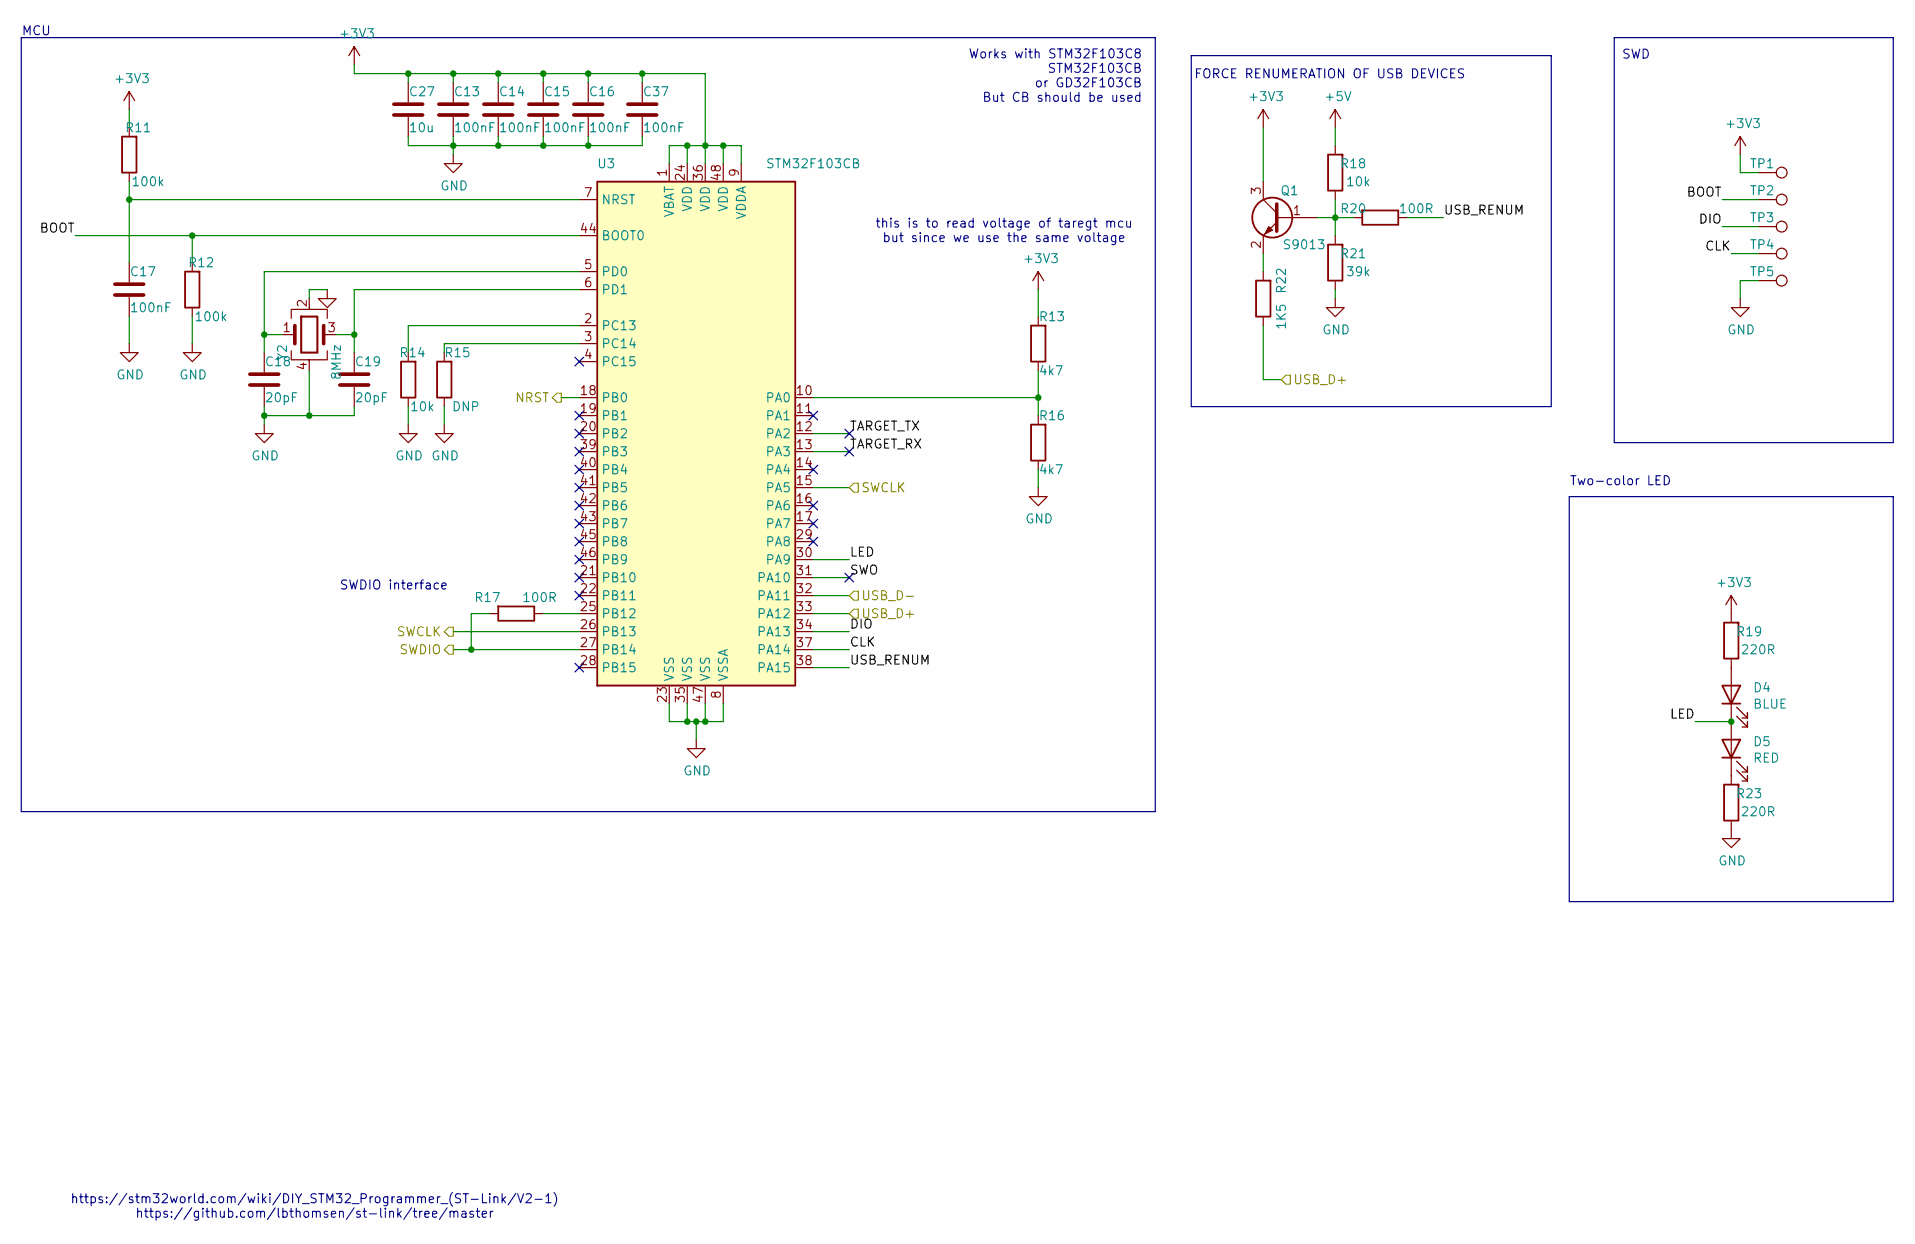
[picture p14: schematic STLINK.kicad_sch, STLNIK v2]

Parts:
C13, C14, C15, C16, C17, C37: 100nF; C_0402_1005Metric; LCSC C1525
C18, C19: 20pF; C_0402_1005Metric; LCSC C1554
C27: 10u; C_0805_2012Metric
D4: BLUE; LED_0603_1608Metric; LCSC C72041
D5: RED; LED_0603_1608Metric; LCSC C2286
Q1: S9013; SOT-23; LCSC C6749
R11, R12: 100k; R_0402_1005Metric; LCSC C25741
R13, R16: 4k7; R_0402_1005Metric; LCSC C25900
R14, R18: 10k; R_0402_1005Metric; LCSC C25744
R15: DNP; R_0402_1005Metric; LCSC xxC25744
R17: 100R; R_0603_1608Metric; LCSC C25076
R19, R23: 220R; R_0402_1005Metric; LCSC C25091
R20: 100R; R_0402_1005Metric; LCSC C25076
R21: 39k; R_0402_1005Metric; LCSC C25783
R22: 1K5; R_0402_1005Metric; LCSC C25867
TP1, TP2, TP3, TP4, TP5: TestPoint_Pad_1.0x1.0mm
U3: STM32F103CB; LQFP-48_7x7mm_P0.5mm; LCSC C8304
Y2: 8MHz; Crystal_SMD_3225-4Pin_3.2x2.5mm

Connections:
+3V3: C13.1, C14.1, C15.1, C16.1, C27.1, C37.1, Q1.3 (C), R11.2, R13.2, R19.2, TP1.1, U3.1 (VBAT), U3.9 (VDDA), U3.24 (VDD), U3.36 (VDD), U3.48 (VDD); also elsewhere on the board
+5V: R18.2; also elsewhere on the board
/STLINK/BOOT: R12.2, TP2.1, U3.44 (BOOT0)
/STLINK/CLK: TP4.1, U3.37 (PA14)
/STLINK/DIO: TP3.1, U3.34 (PA13)
/STLINK/LED: D4.1 (K), D5.2 (A), U3.30 (PA9)
/STLINK/NRST: U3.18 (PB0); also elsewhere on the board
/STLINK/SWCLK: U3.15 (PA5), U3.26 (PB13); also elsewhere on the board
/STLINK/SWDIO: R17.2, U3.27 (PB14); also elsewhere on the board
/STLINK/SWO: U3.31 (PA10)
/STLINK/TARGET_RX: U3.13 (PA3)
/STLINK/TARGET_TX: U3.12 (PA2)
/STLINK/USB_D+: R22.1, U3.33 (PA12); also elsewhere on the board
/STLINK/USB_D-: U3.32 (PA11); also elsewhere on the board
/STLINK/USB_RENUM: R20.1, U3.38 (PA15)
GND: C13.2, C14.2, C15.2, C16.2, C17.2, C18.2, C19.2, C27.2, C37.2, R12.1, R14.1, R15.1, R16.1, R21.1, R23.1, TP5.1, U3.8 (VSSA), U3.23 (VSS), U3.35 (VSS), U3.47 (VSS), Y2.2, Y2.4; also elsewhere on the board
unnamed: D4.2 (A), R19.1
unnamed: D5.1 (K), R23.2
unnamed: Q1.1 (B), R18.1, R20.2, R21.2
unnamed: Q1.2 (E), R22.2
unnamed: C17.1, R11.1, U3.7 (NRST)
unnamed: R13.1, R16.2, U3.10 (PA0)
unnamed: R17.1, U3.25 (PB12)
unnamed: R14.2, U3.2 (PC13)
unnamed: R15.2, U3.3 (PC14)
unnamed: C18.1, U3.5 (PD0), Y2.1
unnamed: C19.1, U3.6 (PD1), Y2.3

Notes on the sheet:
this is to read voltage of taregt mcu but since we use the same voltage
https://stm32world.com/wiki/DIY_STM32_Programmer_(ST-Link/V2-1) https://github.com/lbthomsen/st-link/tree/master
SWDIO interface
Works with STM32F103C8 STM32F103CB or GD32F103CB But CB should be used
FORCE RENUMERATION OF USB DEVICES
MCU
Two-color LED
SWD

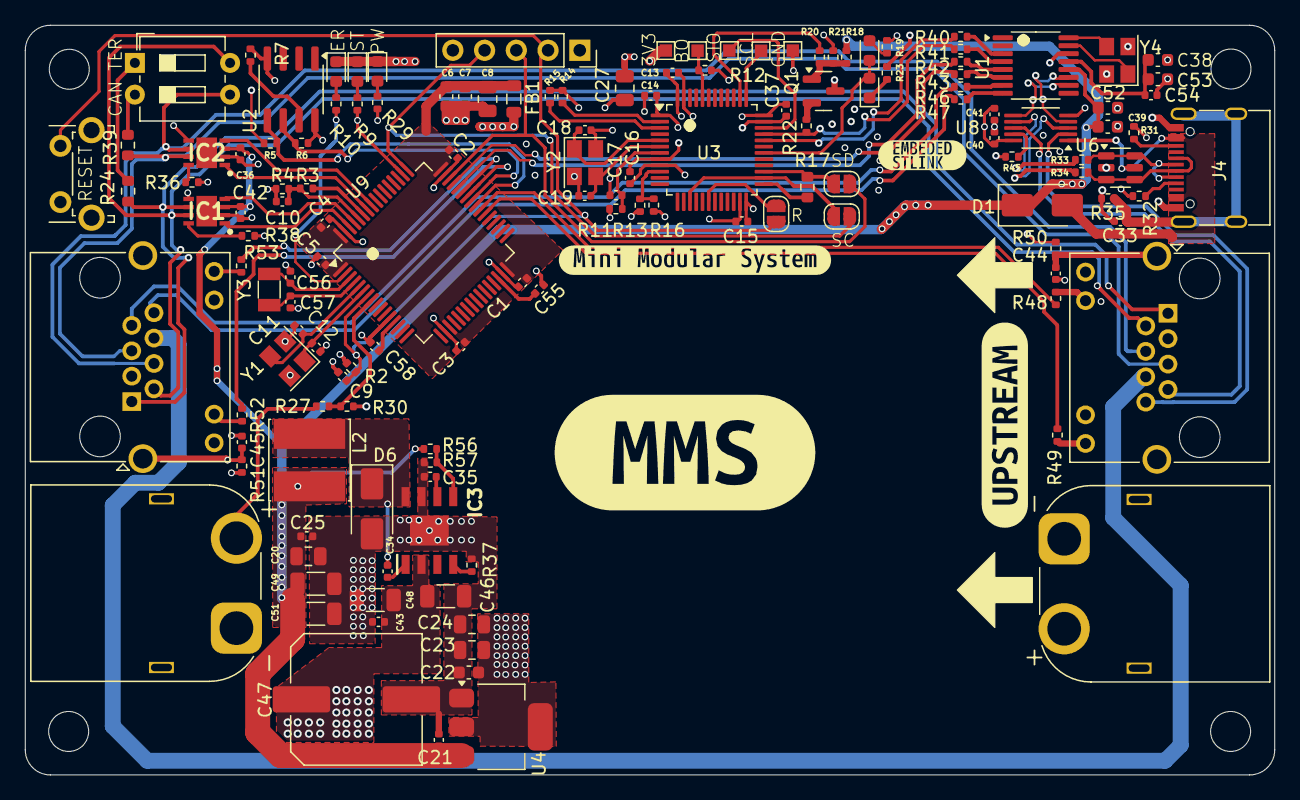
[picture p15: board mini_module_template.kicad_pcb from above]

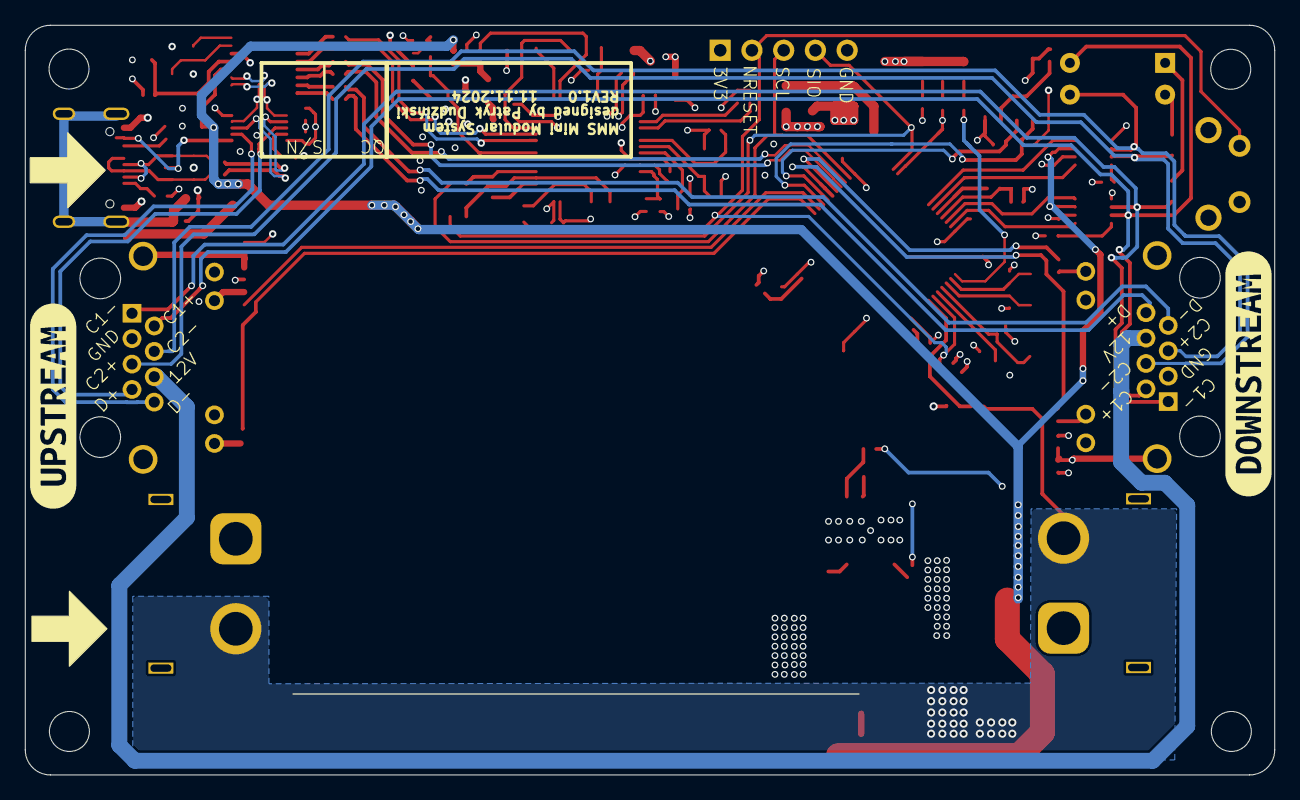
[picture p16: board mini_module_template.kicad_pcb from below]

Board: 4 copper layers, 100.0 x 60.0 mm, 150 parts (2 on the bottom side), 99 nets.

Other parts of the board:
kibuzzard-674CE2D2: G***; kibuzzard-674CE2D2
kibuzzard-67314D46: G***; kibuzzard-67314D46
kibuzzard-673147F0, kibuzzard-673147F0#2: G***; kibuzzard-673147F0
kibuzzard-673151BF: G***; kibuzzard-673151BF
kibuzzard-67314807: G***; kibuzzard-67314807
