KoNarRobotics/ModuCard-System/(commit log)

2024-12-29 Add CI, remove trash
    [CH334R.kicad_sch, CanTerminators.kicad_sch, Connector.kicad_sch, ModuCard-System-ActiveBackplane.kicad_sch, Mounting holes.kicad_sch, PSUbreakout.kicad_sch, din_41612_female_c-96abct.stp]
2024-12-29 Upload everything as artifact, change test KiCad project
    [CH334R.kicad_sch, CanTerminators.kicad_sch, Connector.kicad_sch, ModuCard-System-ActiveBackplane.kicad_sch, Mounting holes.kicad_sch, PSUbreakout.kicad_sch, power-board.kicad_pcb, power-board.kicad_sch]
2024-12-29 Add backplane project back
    [CH334R.kicad_sch, CanTerminators.kicad_sch, Connector.kicad_sch, ModuCard-System-ActiveBackplane.kicad_sch, Mounting holes.kicad_sch, PSUbreakout.kicad_sch, din_41612_female_c-96abct.stp, power-board.kicad_pcb]
2024-12-29 Add mini modular as test
    [CH334R.kicad_sch, CanTerminators.kicad_sch, Connector.kicad_sch, MCU.kicad_sch, ModuCard-System-ActiveBackplane.kicad_sch, Mounting holes.kicad_sch, POWER.kicad_sch, PSUbreakout.kicad_sch]
2024-12-29 Add generated schematic PDF, necessary Gerber layers, and 3D model
    [mini_module_template-B_Cu.gbr, mini_module_template-B_Mask.gbr, mini_module_template-B_Paste.gbr, mini_module_template-B_Silkscreen.gbr, mini_module_template-Edge_Cuts.gbr, mini_module_template-F_Cu.gbr, mini_module_template-F_Mask.gbr, mini_module_template-F_Paste.gbr]
